alexgodin/jishatimer/kicad/.step

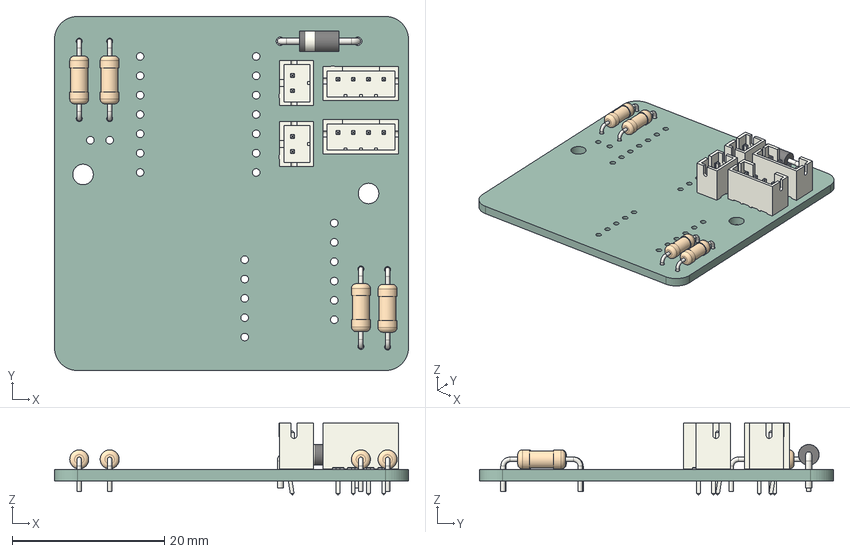
[picture p1: CAD file, 2026-07-18]
kicad/.step
46.5 x 46.5 x 9.40 mm
D_DO-41_SOD81_P10.16mm_Horizontal
R_Axial_DIN0207_L6.3mm_D2.5mm_P10.16mm_Horizontal x 4
JST_PH_B2B-PH-K_1x02_P2.00mm_Vertical x 2
JST_PH_B4B-PH-K_1x04_P2.00mm_Vertical x 2
jishatimer_PCB
