alexgodin/jishatimer/kicad/jishatimer.kicad_pcb

## KiCad design kicad/jishatimer.kicad_pcb (2026-07-18)

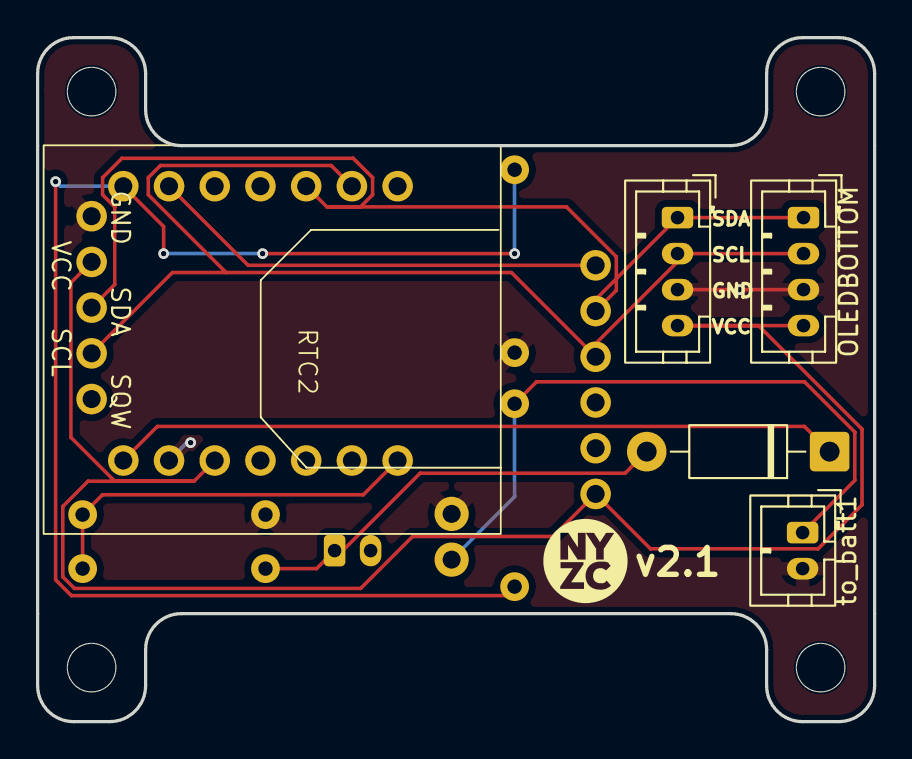
[picture p2: board jishatimer.kicad_pcb from above]

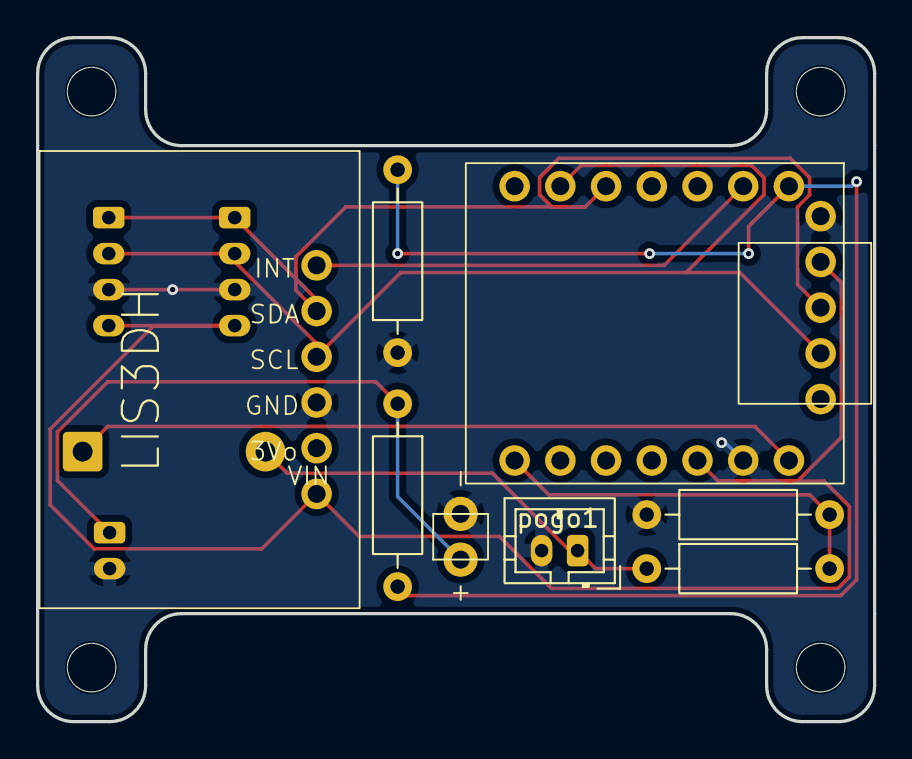
[picture p3: board jishatimer.kicad_pcb from below]

Board: 2 copper layers, 46.5 x 38.0 mm, 17 parts (8 on the bottom side), 10 nets.

Parts:
Accelerometer2: Adafruit_LIS3DH
Hole1, Hole1#2, Hole1#3, Hole2: MountingHole_2.7mm
OLEDBOTTOM1: JST_PH_B4B-PH-K_1x04_P2.00mm_Vertical
OLEDTOP1: JST_PH_B4B-PH-K_1x04_P2.00mm_Vertical
R1, R2, R3, R4: R; R_Axial_DIN0207_L6.3mm_D2.5mm_P10.16mm_Horizontal
RTC2: Adafruit_ PCF8523
Schottky1: D_Schottky; D_DO-41_SOD81_P10.16mm_Horizontal
XIAO1: Xiao_ESP32_C3
pogo1: JST_PH_B2B-PH-K_1x02_P2.00mm_Vertical
to_batt1: JST_PH_B2B-PH-K_1x02_P2.00mm_Vertical
to_xiao1: xiao_battery_connection

Connections:
+BATT: R2.1, to_batt1.1 (VCC), to_xiao1.+
GND: Accelerometer2.GND, OLEDBOTTOM1.3 (GND), OLEDTOP1.3 (GND), R1.1, R3.2, RTC2.GND, XIAO1.GND, pogo1.2 (GND), to_batt1.2 (GND), to_xiao1.-
unnamed: Accelerometer2.SCL, OLEDBOTTOM1.2 (SCL), OLEDTOP1.2 (SCL), RTC2.SCL, XIAO1.D5 (SCL)
unnamed: Accelerometer2.SDA, OLEDBOTTOM1.1 (SDA), OLEDTOP1.1 (SDA), RTC2.SDA, XIAO1.D4 (SDA)
unnamed: Accelerometer2.VIN, OLEDBOTTOM1.4 (VCC), OLEDTOP1.4 (VCC), RTC2.VCC, XIAO1.3V3 (3.3V)
unnamed: R3.1, R4.2, XIAO1.D7
unnamed: Schottky1.1 (K), XIAO1.5V (VUSB)
unnamed: R1.2, R2.2, XIAO1.D0 (A0)
unnamed: Accelerometer2.INT, XIAO1.D1 (A1)
VCC: R4.1, Schottky1.2 (A), pogo1.1 (+5v)
