alexgodin/jishatimer/kicad/jishatimer-v1.kicad_pcb

## KiCad design kicad/jishatimer-v1.kicad_pcb (2026-07-18)

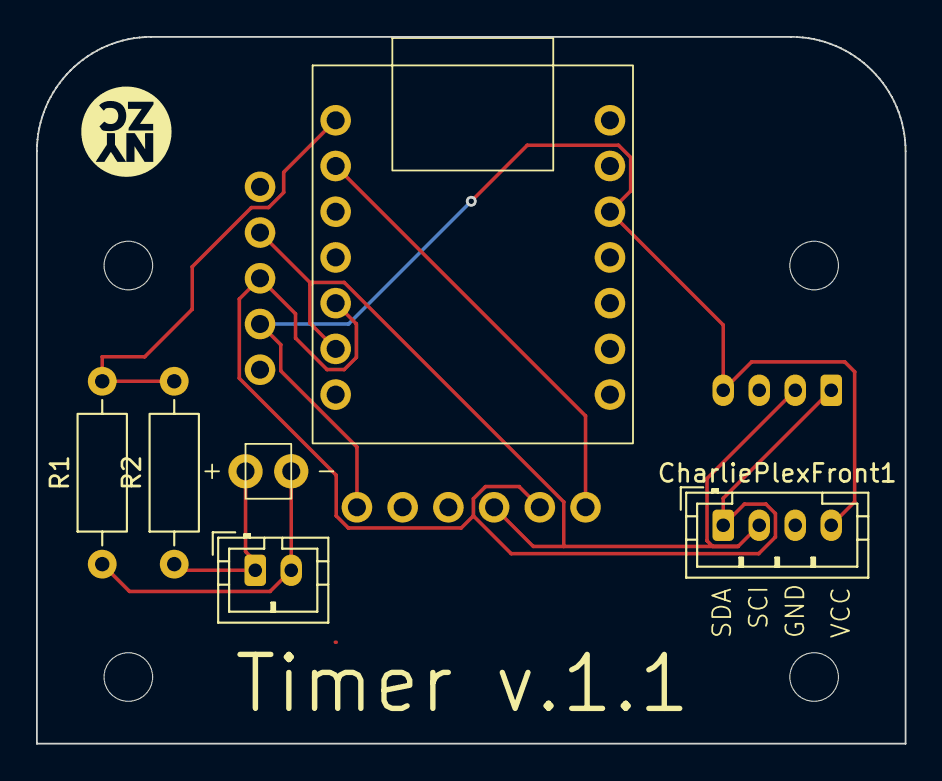
[picture p4: board jishatimer-v1.kicad_pcb from above]

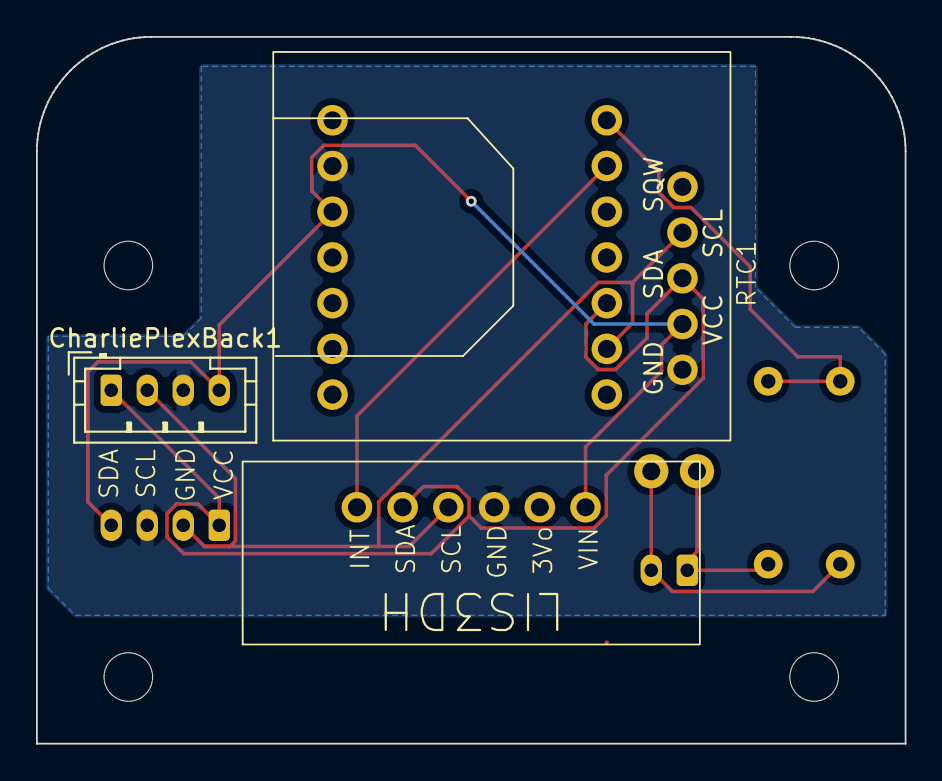
[picture p5: board jishatimer-v1.kicad_pcb from below]

Board: 2 copper layers, 48.3 x 39.3 mm, 9 parts (3 on the bottom side), 8 nets.

Parts:
Accelerometer1: Adafruit_LIS3DH
CharliePlexBack1: JST_PH_B4B-PH-K_1x04_P2.00mm_Vertical
CharliePlexFront1: JST_PH_B4B-PH-K_1x04_P2.00mm_Vertical
R1, R2: R; R_Axial_DIN0207_L6.3mm_D2.5mm_P10.16mm_Horizontal
RTC1: Adafruit_ PCF8523
XIAO1: Xiao_ESP32_C3
to_batt1: JST_PH_B2B-PH-K_1x02_P2.00mm_Vertical
to_xiao1: xiao_battery_connection

Connections:
unnamed: Accelerometer1.GND, CharliePlexBack1.3 (GND), CharliePlexFront1.3 (GND), RTC1.GND, XIAO1.GND
unnamed: Accelerometer1.VIN, CharliePlexBack1.4 (VCC), CharliePlexFront1.4 (VCC), RTC1.VCC, XIAO1.3V3 (3.3V)
unnamed: R1.2, R2.2, XIAO1.D0 (A0)
unnamed: Accelerometer1.INT, XIAO1.D1 (A1)
unnamed: Accelerometer1.SCL, CharliePlexBack1.2 (SCL), CharliePlexFront1.2 (SCL), RTC1.SCL, XIAO1.D5 (SCL)
unnamed: Accelerometer1.SDA, CharliePlexBack1.1 (SDA), CharliePlexFront1.1 (SDA), RTC1.SDA, XIAO1.D4 (SDA)
unnamed: R2.1, to_batt1.1 (+), to_xiao1.+
unnamed: R1.1, to_batt1.2 (-), to_xiao1.-
