alexgodin/jishatimer/src/logo.h

#ifndef LOGO_H
#define LOGO_H

#include <Arduino.h>

// NYZC logo mark, generated from "nyzc blackandwhite logo.svg":
//   rsvg-convert -w 512 -h 512 --background-color=none logo.svg -o logo_512.png
//   magick logo_512.png -resize 56x56 -background white -flatten \
//     -colorspace Gray -threshold 50% -depth 1 -type bilevel logo_56.xbm
// bit=1 renders as a lit pixel via drawXBMP: the circular mark lights up,
// with "NYZC" appearing as dark cutouts inside it.

#define LOGO_WIDTH  56
#define LOGO_HEIGHT 56

static const unsigned char LOGO_BITS[] PROGMEM = {
  0x00, 0x00, 0xC0, 0xFF, 0x03, 0x00, 0x00, 0x00, 0x00, 0xF8, 0xFF, 0x1F,
  0x00, 0x00, 0x00, 0x00, 0xFF, 0xFF, 0xFF, 0x00, 0x00, 0x00, 0x80, 0xFF,
  0xFF, 0xFF, 0x03, 0x00, 0x00, 0xE0, 0xFF, 0xFF, 0xFF, 0x07, 0x00, 0x00,
  0xF8, 0xFF, 0xFF, 0xFF, 0x1F, 0x00, 0x00, 0xFC, 0xFF, 0xFF, 0xFF, 0x3F,
  0x00, 0x00, 0xFE, 0xFF, 0xFF, 0xFF, 0x7F, 0x00, 0x00, 0xFF, 0xFF, 0xFF,
  0xFF, 0xFF, 0x00, 0x80, 0x07, 0x7E, 0x00, 0xFC, 0x83, 0x01, 0xC0, 0x07,
  0x7C, 0x10, 0xF8, 0x81, 0x03, 0xE0, 0x07, 0x7C, 0x30, 0xF8, 0xC0, 0x07,
  0xE0, 0x07, 0x78, 0x30, 0xF0, 0xE0, 0x07, 0xF0, 0x07, 0x70, 0x70, 0x60,
  0xE0, 0x0F, 0xF0, 0x07, 0x70, 0xF0, 0x20, 0xF0, 0x1F, 0xF8, 0x07, 0x60,
  0xF0, 0x00, 0xF8, 0x1F, 0xF8, 0x07, 0x40, 0xF0, 0x01, 0xF8, 0x3F, 0xFC,
  0x07, 0x40, 0xF0, 0x03, 0xFC, 0x3F, 0xFC, 0x07, 0x00, 0xF0, 0x03, 0xFE,
  0x3F, 0xFE, 0x07, 0x02, 0xF0, 0x07, 0xFE, 0x7F, 0xFE, 0x07, 0x06, 0xF0,
  0x07, 0xFF, 0x7F, 0xFE, 0x07, 0x06, 0xF0, 0x07, 0xFF, 0x7F, 0xFE, 0x07,
  0x0E, 0xF0, 0x07, 0xFF, 0xFF, 0xFF, 0x07, 0x0E, 0xF0, 0x07, 0xFF, 0xFF,
  0xFF, 0x07, 0x1E, 0xF0, 0x07, 0xFF, 0xFF, 0xFF, 0x07, 0x3E, 0xF0, 0x07,
  0xFF, 0xFF, 0xFF, 0x07, 0x3E, 0xF0, 0x07, 0xFF, 0xFF, 0xFF, 0xFF, 0xFF,
  0xFF, 0xFF, 0xFF, 0xFF, 0xFF, 0xFF, 0xFF, 0xFF, 0x0F, 0xFC, 0xFF, 0xFF,
  0x07, 0x00, 0xF8, 0x01, 0xF0, 0xFF, 0xFF, 0x07, 0x00, 0x78, 0x00, 0xF0,
  0xFF, 0xFF, 0x07, 0x00, 0x3C, 0x00, 0xE0, 0xFF, 0xFF, 0x07, 0x00, 0x3E,
  0x00, 0xF0, 0xFF, 0xFE, 0xFF, 0x07, 0x1E, 0xF8, 0xF9, 0xFF, 0xFE, 0xFF,
  0x03, 0x1F, 0xFC, 0xFF, 0x7F, 0xFE, 0xFF, 0x83, 0x0F, 0xFC, 0xFF, 0x7F,
  0xFE, 0xFF, 0x81, 0x0F, 0xFE, 0xFF, 0x7F, 0xFC, 0xFF, 0xC0, 0x0F, 0xFE,
  0xFF, 0x3F, 0xFC, 0xFF, 0xE0, 0x0F, 0xFE, 0xFF, 0x3F, 0xF8, 0x7F, 0xF0,
  0x0F, 0xFE, 0xFF, 0x3F, 0xF8, 0x3F, 0xF0, 0x0F, 0xFC, 0xFF, 0x1F, 0xF0,
  0x3F, 0xF8, 0x1F, 0xF8, 0xFB, 0x1F, 0xF0, 0x1F, 0x00, 0x18, 0xF0, 0xF0,
  0x0F, 0xE0, 0x0F, 0x00, 0x38, 0x00, 0xF0, 0x07, 0xE0, 0x07, 0x00, 0x78,
  0x00, 0xE0, 0x07, 0xC0, 0x07, 0x00, 0xF8, 0x00, 0xF0, 0x03, 0x80, 0x07,
  0x00, 0xF8, 0x03, 0xFC, 0x01, 0x00, 0xFF, 0xFF, 0xFF, 0xFF, 0xFF, 0x00,
  0x00, 0xFE, 0xFF, 0xFF, 0xFF, 0x7F, 0x00, 0x00, 0xFC, 0xFF, 0xFF, 0xFF,
  0x3F, 0x00, 0x00, 0xF8, 0xFF, 0xFF, 0xFF, 0x1F, 0x00, 0x00, 0xE0, 0xFF,
  0xFF, 0xFF, 0x07, 0x00, 0x00, 0x80, 0xFF, 0xFF, 0xFF, 0x03, 0x00, 0x00,
  0x00, 0xFE, 0xFF, 0xFF, 0x00, 0x00, 0x00, 0x00, 0xF8, 0xFF, 0x1F, 0x00,
  0x00, 0x00, 0x00, 0xC0, 0xFF, 0x03, 0x00, 0x00,
};

#endif
