alexgodin/jishatimer/(commit log)

2026-01-23 without working clock
    [jishatimer.kicad_pcb, jishatimer.kicad_sch]
2026-03-03 move NTP sync to setup() to prevent display freeze
    NTP sync was blocking the main loop for up to 10s, freezing the display
    ~15s after every boot. Now runs during setup() before display starts.
    [main.cpp, time_manager.cpp, time_manager.h]
2026-07-18 Replace LED matrix displays with single SH1106 OLED
    Swap the dual IS31FL3731 LED matrix setup for one SH1106 OLED driven
    via U8g2, removing the orientation-based top/bottom display switching
    that's no longer needed. Also make RTC and accelerometer init
    failures non-fatal so the device stays usable with degraded hardware,
    and add serial diagnostic commands (X: OLED probe, I: full I2C scan)
    plus a matching hardware test suite check.
    Ignore KiCad's auto-generated backup/history/lock files going forward.
    [.step, jishatimer-schematic-v1.kicad_sch, jishatimer-v1.kicad_pcb, jishatimer.kicad_pcb, jishatimer.kicad_sch, jishatimer3.kicad_pcb]
2026-07-25 Add charge-triggered NTP sync and OLED charging/splash screen
    Replace the 48h background NTP-sync timer with an edge-triggered sync
    that fires exactly when the device starts charging (D7 goes high),
    since a full charge cycle is now the only thing that refreshes the
    clock. The boot splash is replaced with a bitmap logo screen that
    doubles as the charging display: a battery icon + throttled percent
    (checked every 2 minutes to stop flicker from ADC jitter), and a
    border that appears only when the RTC hasn't synced in the last 24
    hours. Also fixes a bug where plugging in mid-session could leave the
    previous screen up for the whole blocking NTP sync, and zero-pads the
    clock's hour display.
    Co-Au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
    [battery.cpp, battery.h, display.cpp, display.h, hardware_test_suite.py, logo.h, main.cpp, time_manager.cpp]
